anthonydotmoe/68k-nano/68000sbc.kicad_pcb

## KiCad design 68000sbc.kicad_pcb (2023-08-12)

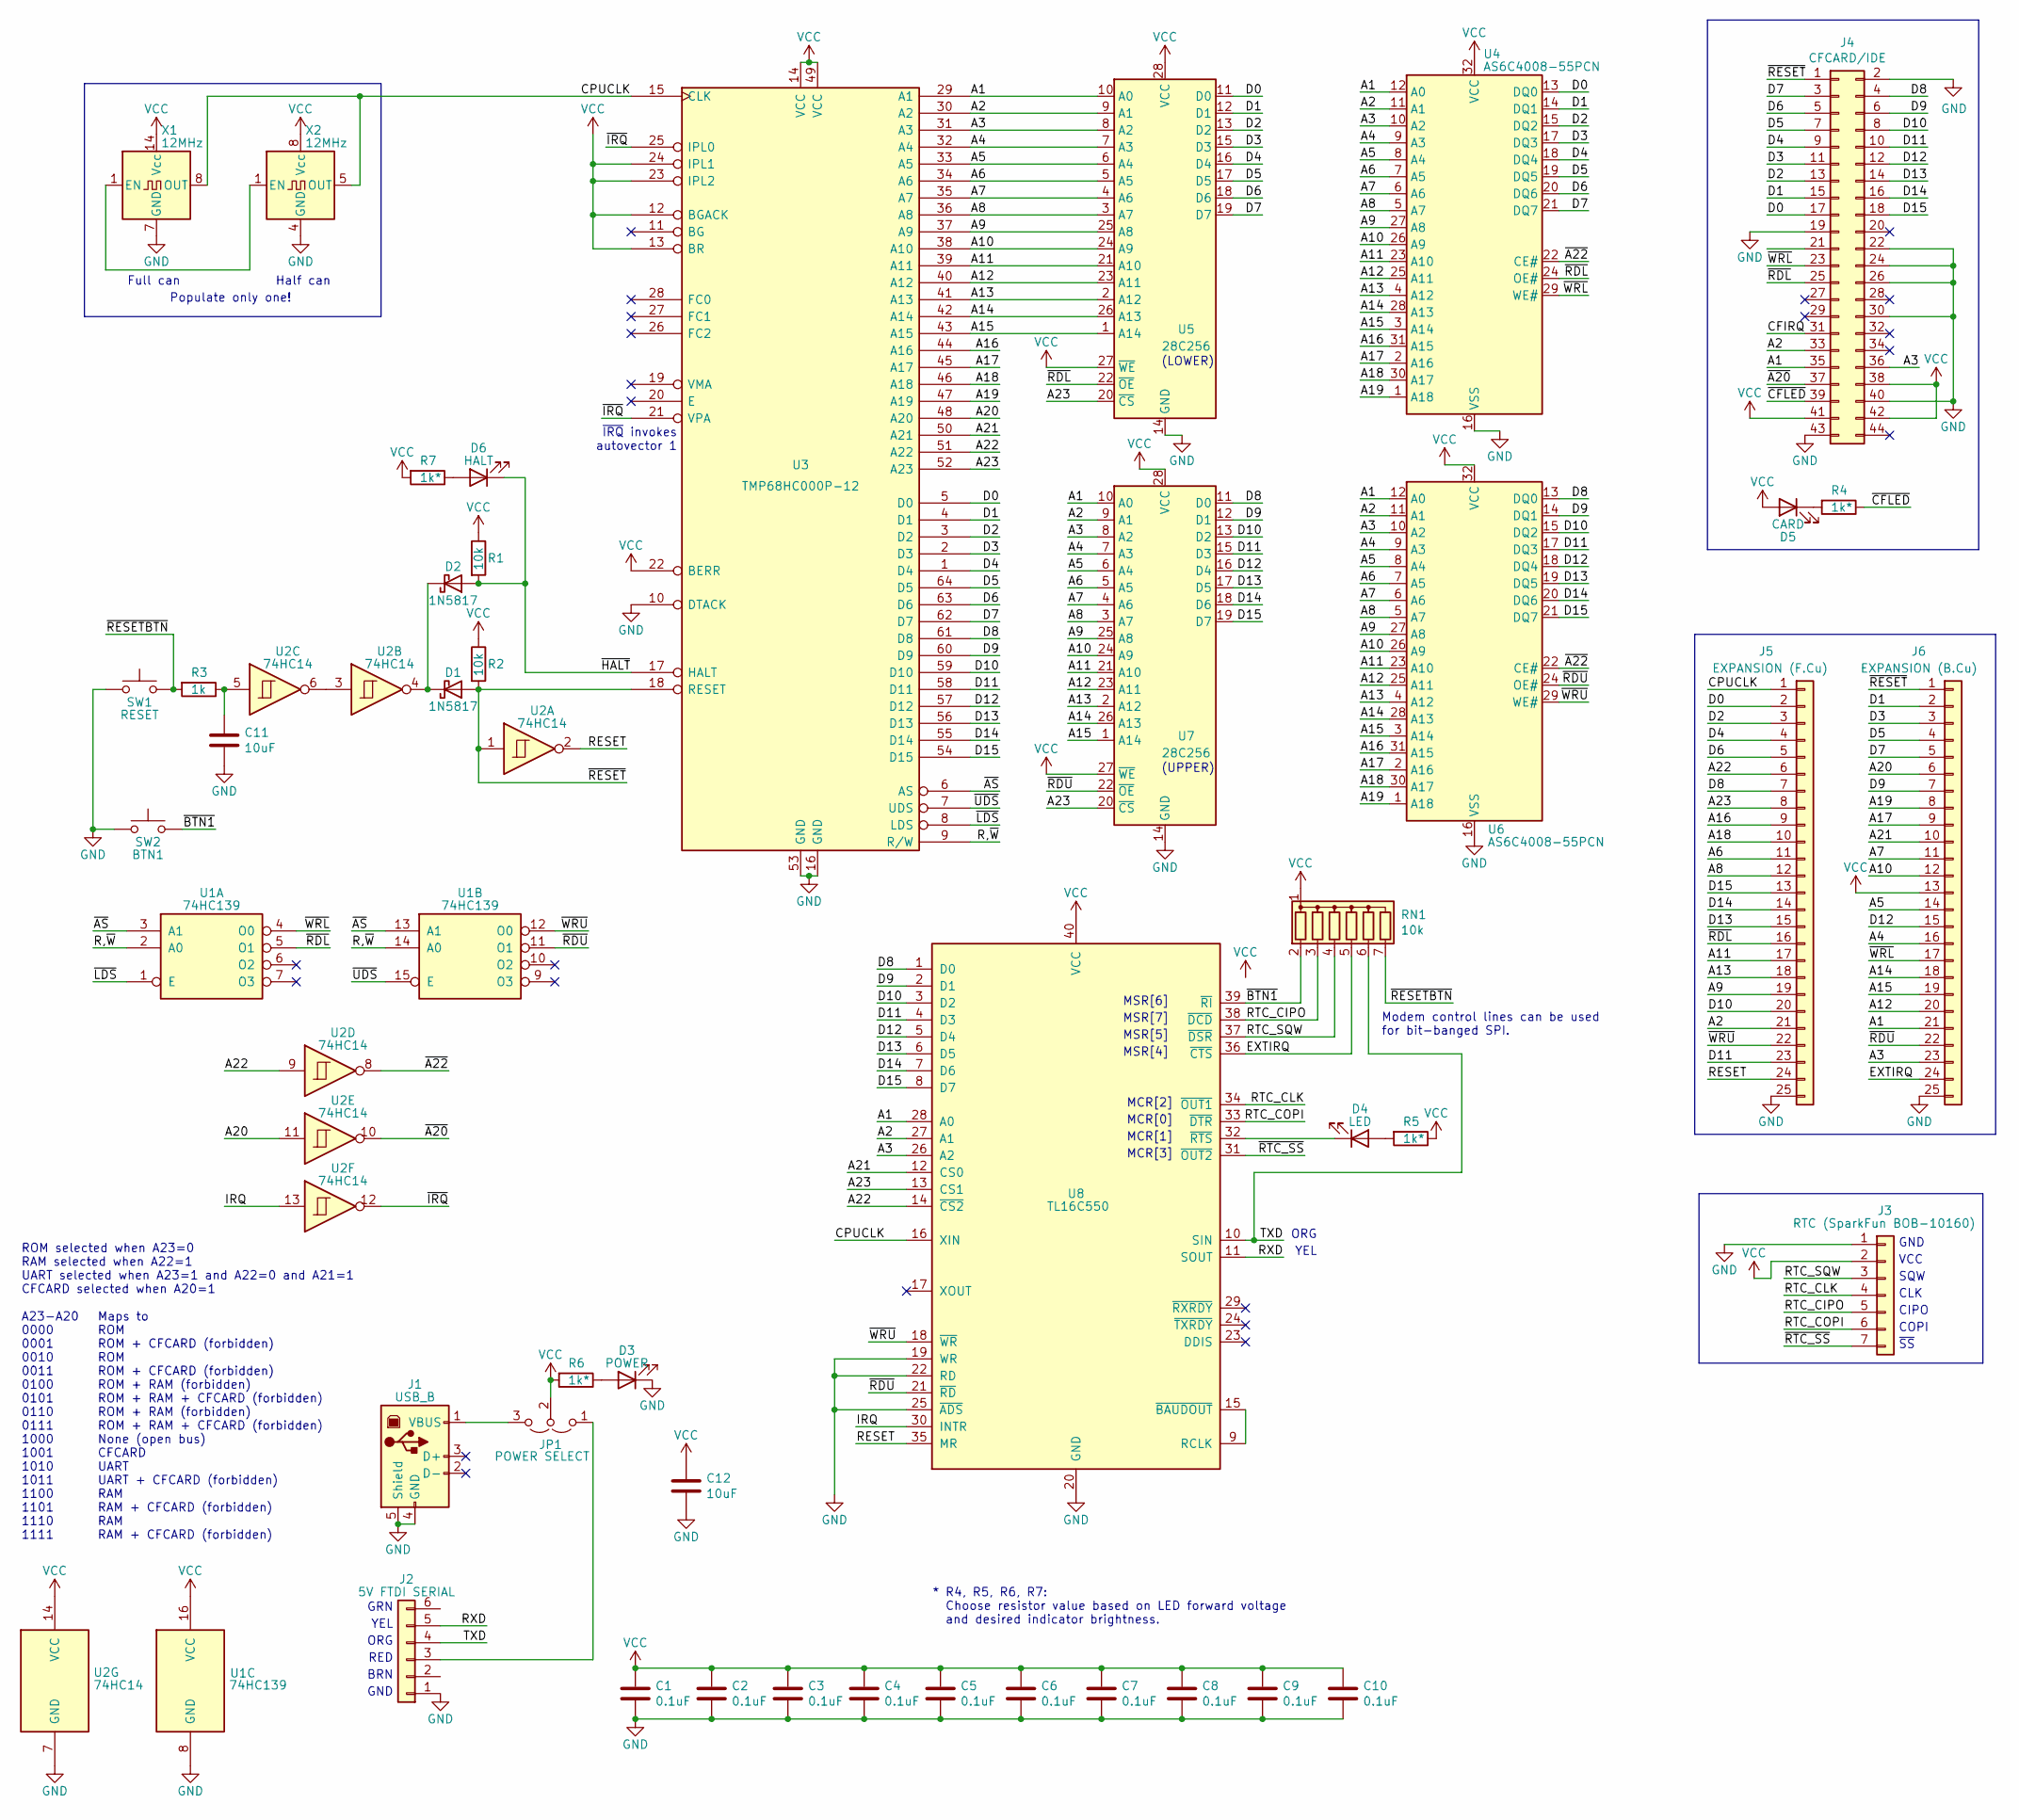
[picture p1: schematic 68000sbc.kicad_sch, 68k nano single board computer]

Parts:
C1, C2, C3, C4, C5, C6, C7, C8, C9, C10: 0.1uF; C_Rect_L7.0mm_W2.0mm_P5.00mm
C11, C12: 10uF; CP_Radial_D5.0mm_P2.50mm
D1, D2: 1N5817; D_DO-35_SOD27_P7.62mm_Horizontal
D3: POWER; LED_D5.0mm
D4: LED; LED_D5.0mm
D5: CARD; LED_D5.0mm
D6: HALT; LED_D5.0mm
J1: USB_B; USB_B_OST_USB-B1HSxx_Horizontal
J2: 5V FTDI SERIAL; PinHeader_1x06_P2.54mm_Horizontal
J3: RTC (SparkFun BOB-10160); PinHeader_1x07_P2.54mm_Vertical
J4: CFCARD/IDE; PinHeader_2x22_P2.00mm_Vertical
J5: EXPANSION (F.Cu); PadRow_1x25_P2.54mm
J6: EXPANSION (B.Cu); PadRow_1x25_P2.54mm
JP1: POWER SELECT; PinHeader_1x03_P2.54mm_Vertical
R1, R2: 10k; R_Axial_DIN0204_L3.6mm_D1.6mm_P7.62mm_Horizontal
R3: 1k; R_Axial_DIN0204_L3.6mm_D1.6mm_P7.62mm_Horizontal
R4, R5, R6, R7: 1k*; R_Axial_DIN0204_L3.6mm_D1.6mm_P7.62mm_Horizontal
RN1: 10k; R_Array_SIP7
SW1: RESET; SW_PUSH_6mm
SW2: BTN1; SW_PUSH_6mm
U1: 74HC139; DIP-16_W7.62mm_Socket
U2: 74HC14; DIP-14_W7.62mm_Socket
U3: TMP68HC000P-12; DIP-64_W22.86mm_Socket
U4, U6: AS6C4008-55PCN; DIP-32_W15.24mm_Socket
U5, U7: 28C256; DIP-28_W15.24mm_Socket
U8: TL16C550; DIP-40_W15.24mm_Socket
X1: 12MHz; Oscillator_DIP-14
X2: 12MHz; Oscillator_DIP-8

Connections:
/A1: J4.35, J6.21, U3.29 (A1), U4.12 (A0), U5.10 (A0), U6.12 (A0), U7.10 (A0), U8.28 (A0)
/A2: J4.33, J5.21, U3.30 (A2), U4.11 (A1), U5.9 (A1), U6.11 (A1), U7.9 (A1), U8.27 (A1)
/A3: J4.36, J6.23, U3.31 (A3), U4.10 (A2), U5.8 (A2), U6.10 (A2), U7.8 (A2), U8.26 (A2)
/A4: J6.16, U3.32 (A4), U4.9 (A3), U5.7 (A3), U6.9 (A3), U7.7 (A3)
/A5: J6.14, U3.33 (A5), U4.8 (A4), U5.6 (A4), U6.8 (A4), U7.6 (A4)
/A6: J5.11, U3.34 (A6), U4.7 (A5), U5.5 (A5), U6.7 (A5), U7.5 (A5)
/A7: J6.11, U3.35 (A7), U4.6 (A6), U5.4 (A6), U6.6 (A6), U7.4 (A6)
/A8: J5.12, U3.36 (A8), U4.5 (A7), U5.3 (A7), U6.5 (A7), U7.3 (A7)
/A9: J5.19, U3.37 (A9), U4.27 (A8), U5.25 (A8), U6.27 (A8), U7.25 (A8)
/A10: J6.12, U3.38 (A10), U4.26 (A9), U5.24 (A9), U6.26 (A9), U7.24 (A9)
/A11: J5.17, U3.39 (A11), U4.23 (A10), U5.21 (A10), U6.23 (A10), U7.21 (A10)
/A12: J6.20, U3.40 (A12), U4.25 (A11), U5.23 (A11), U6.25 (A11), U7.23 (A11)
/A13: J5.18, U3.41 (A13), U4.4 (A12), U5.2 (A12), U6.4 (A12), U7.2 (A12)
/A14: J6.18, U3.42 (A14), U4.28 (A13), U5.26 (A13), U6.28 (A13), U7.26 (A13)
/A15: J6.19, U3.43 (A15), U4.3 (A14), U5.1 (A14), U6.3 (A14), U7.1 (A14)
/A16: J5.9, U3.44 (A16), U4.31 (A15), U6.31 (A15)
/A17: J6.9, U3.45 (A17), U4.2 (A16), U6.2 (A16)
/A18: J5.10, U3.46 (A18), U4.30 (A17), U6.30 (A17)
/A19: J6.8, U3.47 (A19), U4.1 (A18), U6.1 (A18)
/A20: J6.6, U2.11, U3.48 (A20)
/A21: J6.10, U3.50 (A21), U8.12 (CS0)
/A22: J5.6, U2.9, U3.51 (A22), U8.14 (~CS2)
/A23: J5.8, U3.52 (A23), U5.20 (~CS), U7.20 (~CS), U8.13 (CS1)
/CFIRQ: J4.31
/CPUCLK: J5.1, U3.15 (CLK), U8.16 (XIN), X1.8 (OUT), X2.5 (OUT)
/D0: J4.17, J5.2, U3.5 (D0), U4.13 (DQ0), U5.11 (D0)
/D1: J4.15, J6.2, U3.4 (D1), U4.14 (DQ1), U5.12 (D1)
/D2: J4.13, J5.3, U3.3 (D2), U4.15 (DQ2), U5.13 (D2)
/D3: J4.11, J6.3, U3.2 (D3), U4.17 (DQ3), U5.15 (D3)
/D4: J4.9, J5.4, U3.1 (D4), U4.18 (DQ4), U5.16 (D4)
/D5: J4.7, J6.4, U3.64 (D5), U4.19 (DQ5), U5.17 (D5)
/D6: J4.5, J5.5, U3.63 (D6), U4.20 (DQ6), U5.18 (D6)
/D7: J4.3, J6.5, U3.62 (D7), U4.21 (DQ7), U5.19 (D7)
/D8: J4.4, J5.7, U3.61 (D8), U6.13 (DQ0), U7.11 (D0), U8.1 (D0)
/D9: J4.6, J6.7, U3.60 (D9), U6.14 (DQ1), U7.12 (D1), U8.2 (D1)
/D10: J4.8, J5.20, U3.59 (D10), U6.15 (DQ2), U7.13 (D2), U8.3 (D2)
/D11: J4.10, J5.23, U3.58 (D11), U6.17 (DQ3), U7.15 (D3), U8.4 (D3)
/D12: J4.12, J6.15, U3.57 (D12), U6.18 (DQ4), U7.16 (D4), U8.5 (D4)
/D13: J4.14, J5.15, U3.56 (D13), U6.19 (DQ5), U7.17 (D5), U8.6 (D5)
/D14: J4.16, J5.14, U3.55 (D14), U6.20 (DQ6), U7.18 (D6), U8.7 (D6)
/D15: J4.18, J5.13, U3.54 (D15), U6.21 (DQ7), U7.19 (D7), U8.8 (D7)
/EXTIRQ: J6.24, RN1.5 (R4), U8.36 (~CTS)
/IRQ: U2.13, U8.30 (INTR)
/R,~W: U1.2 (A0), U1.14 (A0), U3.9 (R/W)
/RESET: J5.24, U2.2, U8.35 (MR)
/RTC_CIPO: J3.5, RN1.3 (R2), U8.38 (~DCD)
/RTC_CLK: J3.4, U8.34 (~OUT1)
/RTC_COPI: J3.6, U8.33 (~DTR)
/RTC_SQW: J3.3, RN1.4 (R3), U8.37 (~DSR)
/RXD: J2.5, U8.11 (SOUT)
/TXD: J2.4, RN1.6 (R5), U8.10 (SIN)
/~A20: J4.37, U2.10
/~A22: U2.8, U4.22 (CE#), U6.22 (CE#)
/~AS: U1.3 (A1), U1.13 (A1), U3.6 (AS)
/~BTN1: RN1.2 (R1), SW2.2, U8.39 (~RI)
/~CFLED: J4.39, R4.1
/~HALT: D2.2 (A), D6.1 (K), R1.2, U3.17 (HALT)
/~IRQ: U2.12, U3.21 (VPA), U3.25 (IPL0)
/~LDS: U1.1 (E), U3.8 (LDS)
/~RDL: J4.25, J5.16, U1.5 (O1), U4.24 (OE#), U5.22 (~OE)
/~RDU: J6.22, U1.11 (O1), U6.24 (OE#), U7.22 (~OE), U8.21 (~RD)
/~RESETBTN: R3.2, RN1.7 (R6), SW1.2
/~RESET: D1.2 (A), J4.1, J6.1, R2.2, U2.1, U3.18 (RESET)
/~RTC_SS: J3.7, U8.31 (~OUT2)
/~UDS: U1.15 (E), U3.7 (UDS)
/~WRL: J4.23, J6.17, U1.4 (O0), U4.29 (WE#)
/~WRU: J5.22, U1.12 (O0), U6.29 (WE#), U8.18 (~WR)
GND: C1.2, C2.2, C3.2, C4.2, C5.2, C6.2, C7.2, C8.2, C9.2, C10.2, C11.2, C12.2, D3.1 (K), J1.4 (GND), J1.5 (Shield), J2.1, J3.1, J4.2, J4.19, J4.22, J4.24, J4.26, J4.30, J4.40, J4.43, J5.25, J6.25, SW1.1, SW2.1, U1.8 (GND), U2.7 (GND), U3.10 (DTACK), U3.16 (GND), U3.53 (GND), U4.16 (VSS), U5.14 (GND), U6.16 (VSS), U7.14 (GND), U8.19 (WR), U8.20 (GND), U8.22 (RD), U8.25 (~ADS), X1.7 (GND), X2.4 (GND)
unnamed: C11.1, R3.1, U2.5
unnamed: D1.1 (K), D2.1 (K), U2.4
unnamed: D3.2 (A), R6.1
unnamed: D4.2 (A), R5.2
unnamed: D4.1 (K), U8.32 (~RTS)
unnamed: D5.1 (K), R4.2
unnamed: D6.2 (A), R7.1
unnamed: J1.1 (VBUS), JP1.3 (B)
unnamed: J2.3, JP1.1 (A)
unnamed: U2.3, U2.6
unnamed: U8.9 (RCLK), U8.15 (~BAUDOUT)
unnamed: X1.1 (EN), X2.1 (EN)
VCC: C1.1, C2.1, C3.1, C4.1, C5.1, C6.1, C7.1, C8.1, C9.1, C10.1, C12.1, D5.2 (A), J3.2, J4.38, J4.41, J4.42, J6.13, JP1.2 (C), R1.1, R2.1, R5.1, R6.2, R7.2, RN1.1 (common), U1.16 (VCC), U2.14 (VCC), U3.12 (BGACK), U3.13 (BR), U3.14 (VCC), U3.22 (BERR), U3.23 (IPL2), U3.24 (IPL1), U3.49 (VCC), U4.32 (VCC), U5.27 (~WE), U5.28 (VCC), U6.32 (VCC), U7.27 (~WE), U7.28 (VCC), U8.40 (VCC), X1.14 (Vcc), X2.8 (Vcc)

Notes on the sheet:
MCR[1]
MSR[6]
COPI
VCC
ORG
A23-A20 0000 0001 0010 0011 0100 0101 0110 0111 1000 1001 1010 1011 1100 1101 1110 1111
MCR[2]
BRN
CLK
GND
(LOWER)
Full can
Half can
YEL
MSR[5]
~{SS}
Modem control lines can be used for bit-banged SPI.
Maps to ROM ROM + CFCARD (forbidden) ROM ROM + CFCARD (forbidden) ROM + RAM (forbidden) ROM + RAM + CFCARD (forbidden) ROM + RAM (forbidden) ROM + RAM + CFCARD (forbidden) None (open bus) CFCARD UART UART + CFCARD (forbidden) RAM RAM + CFCARD (forbidden) RAM RAM + CFCARD (forbidden)
Populate only one!
GRN
(UPPER)
ROM selected when A23=0 RAM selected when A22=1 UART selected when A23=1 and A22=0 and A21=1 CFCARD selected when A20=1
MCR[3]
* R4, R5, R6, R7: Choose resistor value based on LED forward voltage and desired indicator brightness.
CIPO
MSR[4]
MSR[7]
RED
MCR[0]
SQW
~{IRQ} invokes autovector 1

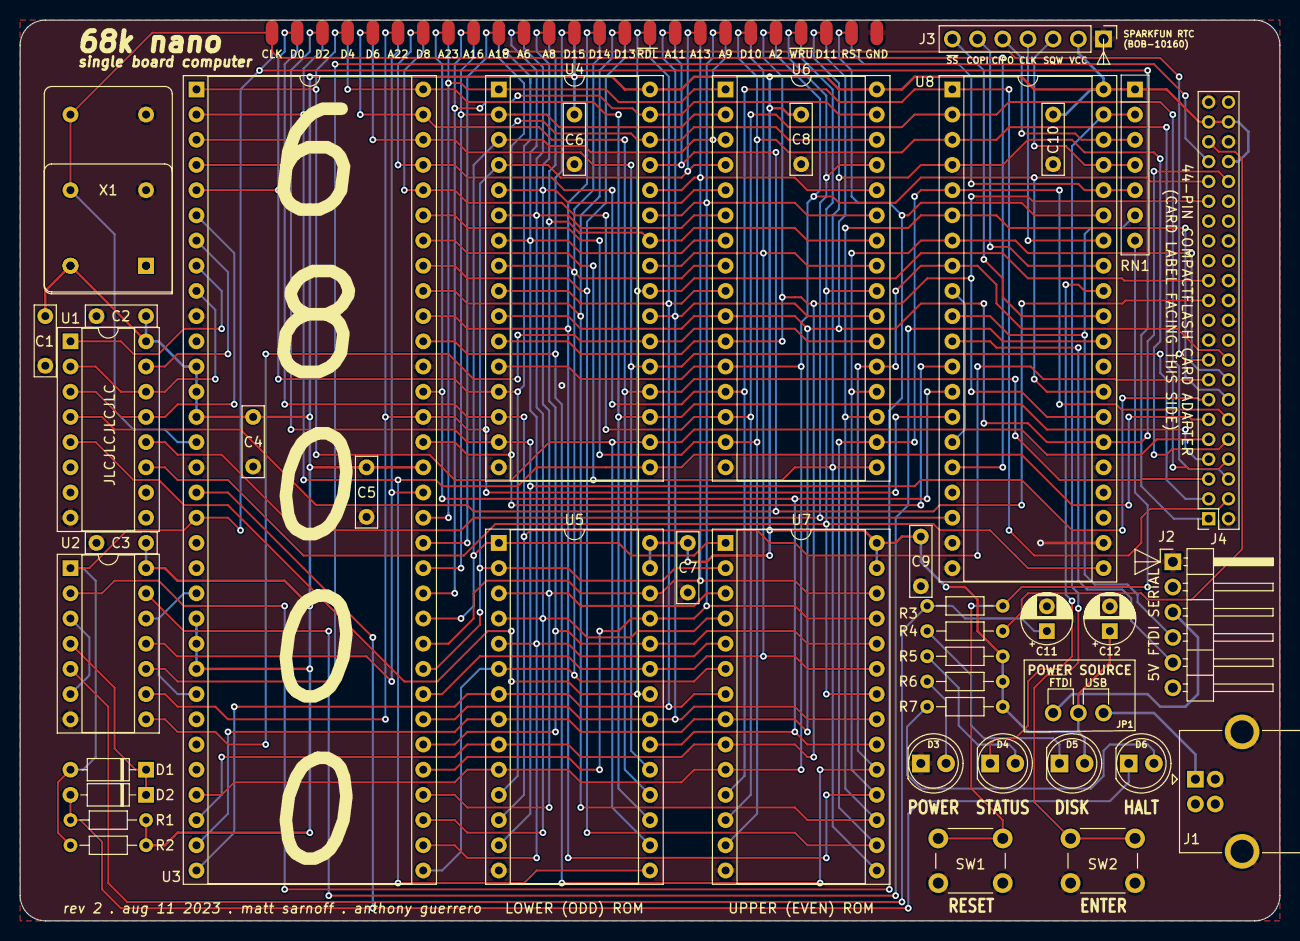
[picture p2: board 68000sbc.kicad_pcb from above]

Board: 2 copper layers, 127.0 x 90.8 mm, 45 parts (1 on the bottom side), 80 nets.
