anthonydotmoe/68k-nano/(commit log)

2023-08-12 Fix track width for JLC requirements
    [68000sbc.kicad_pcb, 68000sbc.kicad_sch]
2023-08-12 remove old KiCad files
    [68000sbc.sch]
2023-08-16 add KiCad lck files
2023-10-21 start drawing expansion slot schematic
    [68000sbc.kicad_sch]
2023-10-22 hopefully working select circuit
    [68000sbc.kicad_sch]
